Astralis1409/vikramsat_rf_subsystem/hardware_rf.step

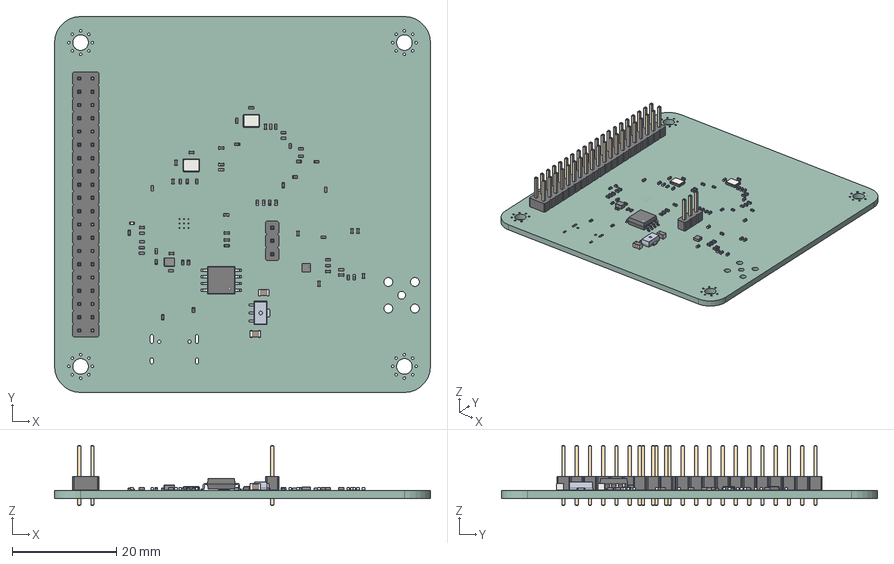
[picture p6: CAD file, 2025-08-02]
hardware_rf.step
72.0 x 72.0 x 11.5 mm
C_0402_1005Metric x 47
LED_0402_1005Metric
R_0402_1005Metric x 14
C_0805_2012Metric x 2
Crystal_SMD_3225-4Pin_3.2x2.5mm x 2
hardware_rf 1.44.1
PinHeader_2x20_P2.54mm_Vertical
IND-SMD_L2.0-W1.6_AOTA-B201610S3R3-101-T
DFN-6_L1.6-W1.6-P0.50-BL-EP1.0
PinHeader_1x03_P2.54mm_Vertical
SOIC-8_5.3x5.3mm_P1.27mm
hardware_rf_PCB
