Astralis1409/vikramsat_rf_subsystem/hardware_rf/footprints/4259-63/3D/4259-63.stp

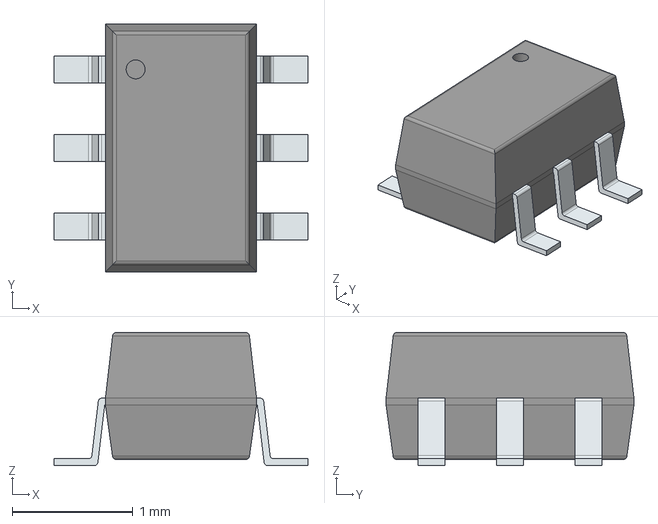
[picture p7: CAD file, 2025-07-22]
hardware_rf/footprints/4259-63/3D/4259-63.stp
2.10 x 2.05 x 1.10 mm
PinsArrayLR
