Astralis1409/vikramsat_rf_subsystem/hardware_rf/footprints/BALF-SPI2-02D3/3D/BALF-SPI2-02D3.stp

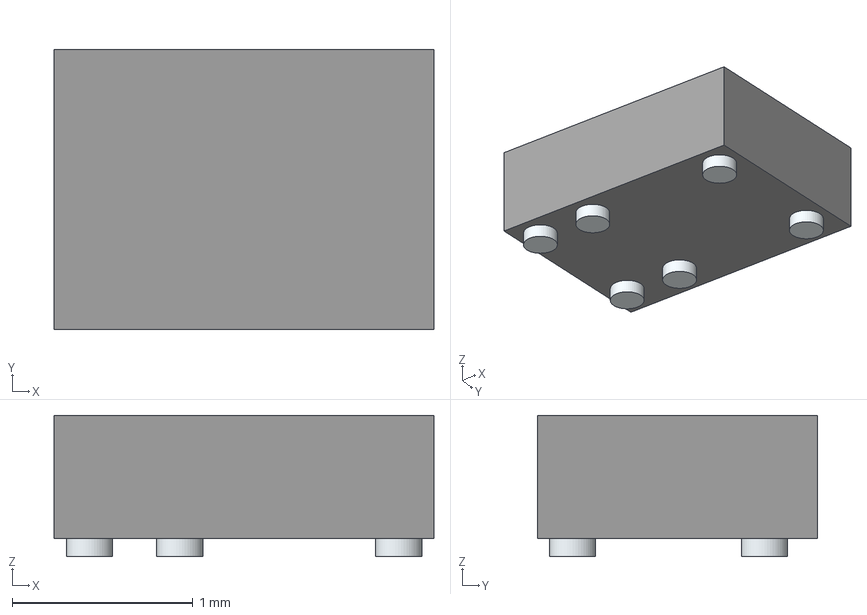
[picture p8: CAD file, 2025-07-22]
hardware_rf/footprints/BALF-SPI2-02D3/3D/BALF-SPI2-02D3.stp
2.10 x 1.55 x 0.78 mm
Pins
