Astralis1409/vikramsat_rf_subsystem/hardware_rf/footprints/CC1125RHBR/3D/CC1125RHBR.stp

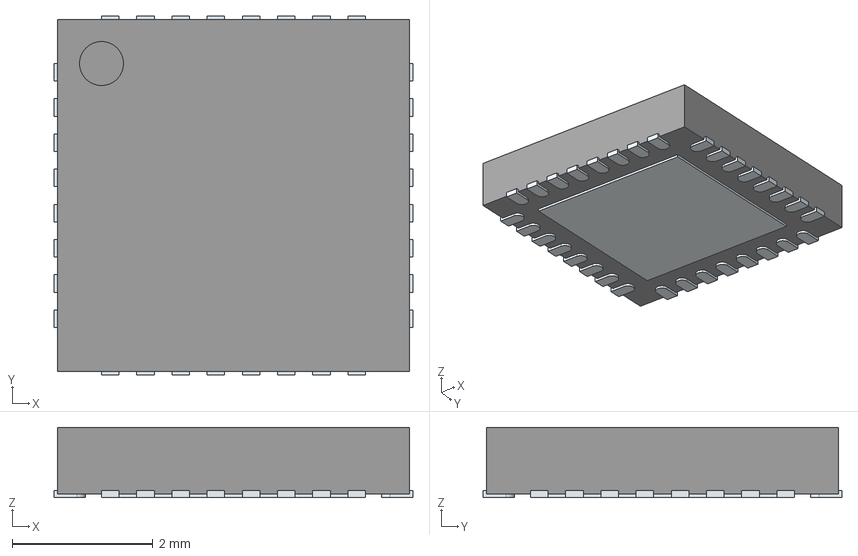
[picture p9: CAD file, 2025-07-10]
hardware_rf/footprints/CC1125RHBR/3D/CC1125RHBR.stp
5.10 x 5.10 x 1.00 mm
ThermalPin
PinsArrayLR
PinsArrayTB
