Astralis1409/vikramsat_rf_subsystem/(list of files, cad)

Other CAD files:
hardware_rf/footprints/4259-63/Allegro/sot65p210x110-6n.psm
hardware_rf/footprints/4259-63/DEHDL/4259_63/chips/chips.prt
hardware_rf/footprints/BALF-SPI2-02D3/Allegro/balfspi202d3.psm
hardware_rf/footprints/BALF-SPI2-02D3/DEHDL/balf_spi2_02d3/chips/chips.prt
hardware_rf/footprints/CC1125RHBR/Allegro/qfn50p500x500x100-33n-d.psm
hardware_rf/footprints/CC1125RHBR/DEHDL/cc1125rhbr/chips/chips.prt
