Astralis1409/vikramsat_rf_subsystem/hardware_rf.pdf

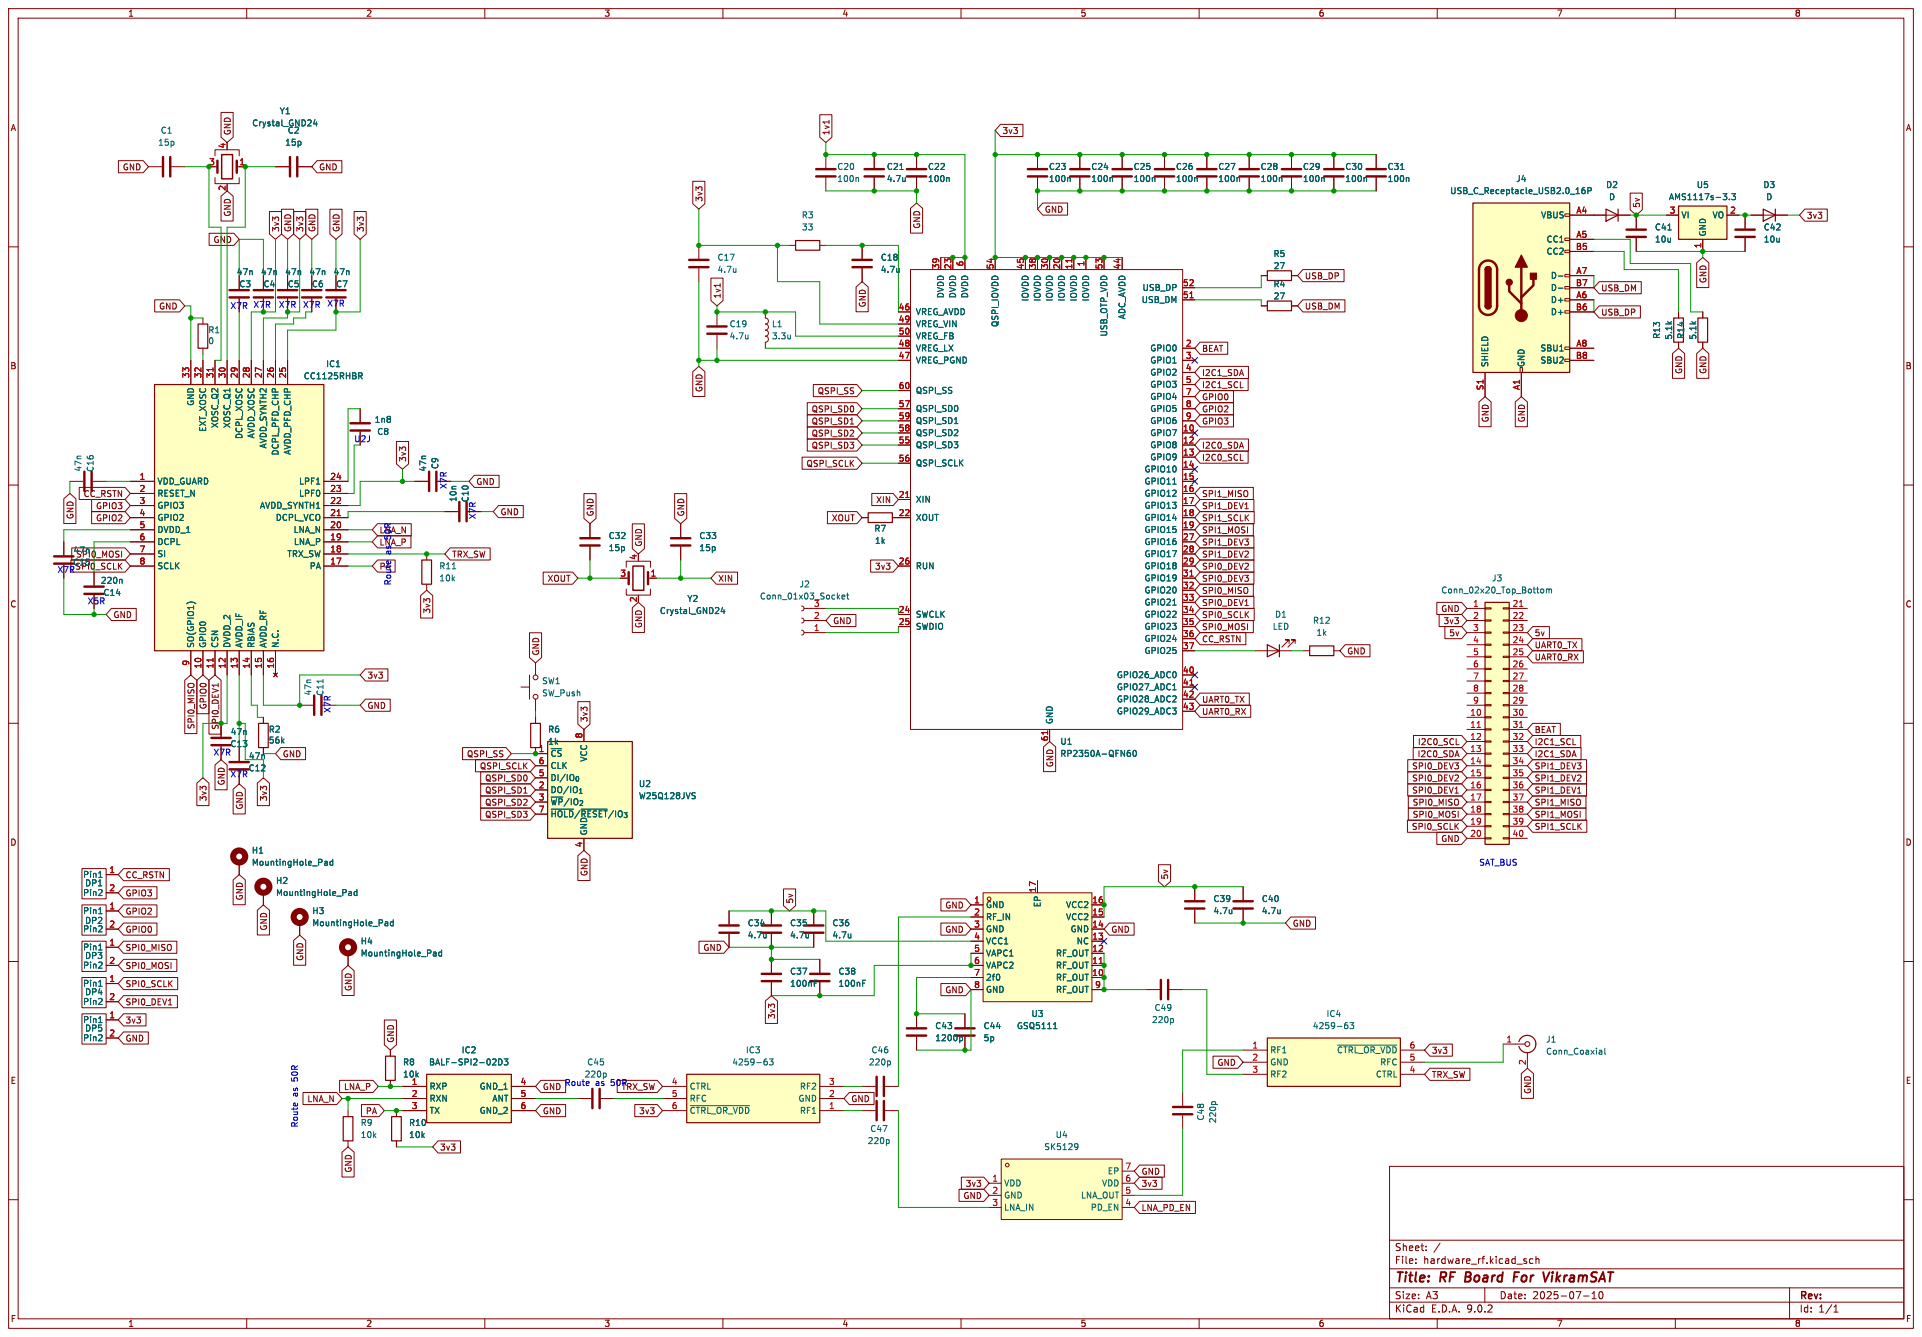
[picture p23: page 1]

6 QSPI_IOVDD 54 IOVDD 45 IOVDD 38 IOVDD 30 IOVDD 20 IOVDD 11 IOVDD

Id: 1/1 Title: RF Board For VikramSAT
