Astralis1409/vikramsat_rf_subsystem/(list of files, drawings)

Other design files:
hardware_rf/footprints/4259-63/Altium/4259-63.SchLib
hardware_rf/footprints/4259-63/Altium/SOT65P210X110-6N.PcbLib
hardware_rf/footprints/BALF-SPI2-02D3/Altium/BALF-SPI2-02D3.SchLib
hardware_rf/footprints/BALF-SPI2-02D3/Altium/BALFSPI202D3.PcbLib
hardware_rf/footprints/CC1125RHBR/Altium/CC1125RHBR.SchLib
hardware_rf/footprints/CC1125RHBR/Altium/QFN50P500X500X100-33N-D.PcbLib
