Astralis1409/vikramsat_rf_subsystem/hardware_rf/hardware_rf.kicad_pcb

## KiCad design hardware_rf/hardware_rf.kicad_pcb (2025-08-16)

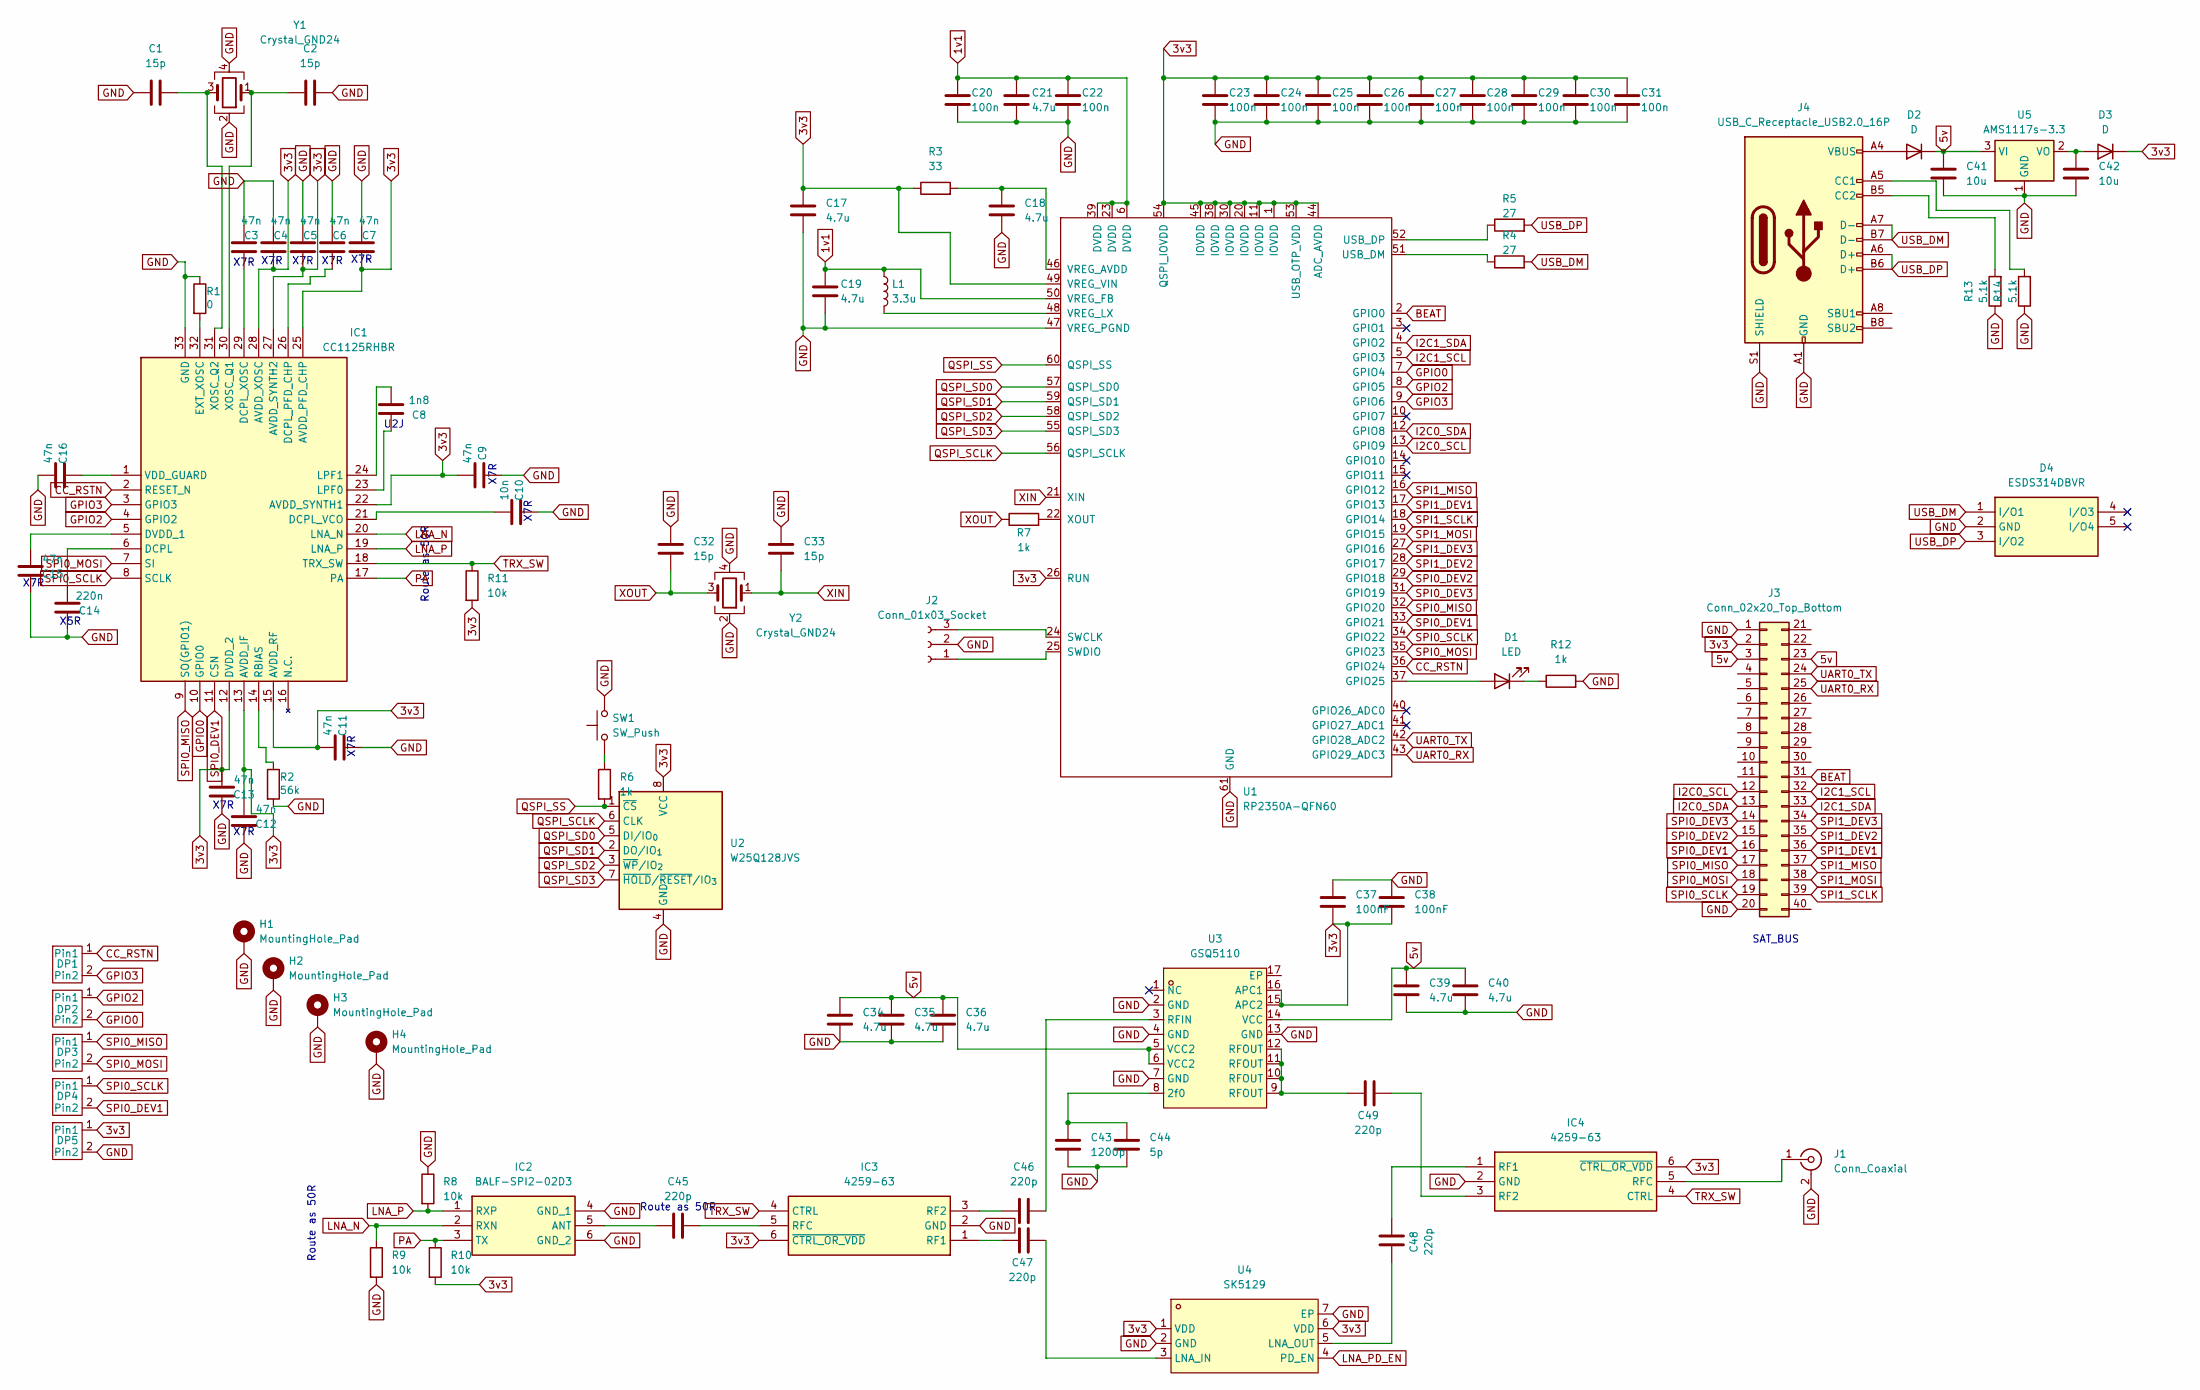
[picture p24: schematic hardware_rf.kicad_sch, RF Board For VikramSAT]

Parts:
C1, C2, C32, C33: 15p; C_0402_1005Metric
C3, C4, C5, C6, C7, C9, C11, C12, C13, C15, C16: 47n; C_0402_1005Metric
C8: 1n8; C_0402_1005Metric
C10: 10n; C_0402_1005Metric
C14: 220n; C_0402_1005Metric
C17, C18, C19, C21, C34, C35, C36, C39, C40: 4.7u; C_0402_1005Metric
C20, C22, C23, C24, C25, C26, C27, C28, C29, C30, C31: 100n; C_0402_1005Metric
C37, C38: 100nF; C_0402_1005Metric
C41, C42: 10u; C_0805_2012Metric
C43: 1200p; C_0402_1005Metric
C44: 5p; C_0402_1005Metric
C45, C46, C47, C48, C49: 220p; C_0402_1005Metric
D1: LED; LED_0402_1005Metric
D2, D3: D; D_0402_1005Metric
D4: ESDS314DBVR; ESDS314BVR_SOT95P280X145-5N; Mouser Part Number 595-ESDS314DBVR
DP1, DP2, DP3, DP4, DP5: Debug Pad
H1, H2, H3, H4: MountingHole_Pad; MountingHole_3mm_Pad_Via
IC1: CC1125RHBR; QFN50P500X500X100-33N-D; Mouser Part Number 595-CC1125RHBR
IC2: BALF-SPI2-02D3; BALFSPI202D3; Mouser Part Number 511-BALF-SPI2-02D3
IC3, IC4: 4259-63; PE4259; Mouser Part Number 81-4259-63
J1: Conn_Coaxial; SMA_Amphenol_901-143_Horizontal
J2: Conn_01x03_Socket; PinHeader_1x03_P2.54mm_Vertical
J3: Conn_02x20_Top_Bottom; PinHeader_2x20_P2.54mm_Vertical
J4: USB_C_Receptacle_USB2.0_16P; USB_C_Receptacle_XKB_U262-16XN-4BVC11
L1: 3.3u; IND-SMD_L2.0-W1.6_AOTA-B201610S3R3-101-T
R1: 0; R_0402_1005Metric
R2: 56k; R_0402_1005Metric
R3: 33; R_0402_1005Metric
R4, R5: 27; R_0402_1005Metric
R6, R7, R12: 1k; R_0402_1005Metric
R8, R9, R10, R11: 10k; R_0402_1005Metric
R13, R14: 5.1k; R_0402_1005Metric
SW1: SW_Push; SW_SPST_PTS810
U1: RP2350A-QFN60; RP2350A_QFN-60_EP_7.75x7.75_Pitch0.4mm
U2: W25Q128JVS; SOIC-8_5.3x5.3mm_P1.27mm
U3: GSQ5110; QFN-16_L3.0-W3.0-P0.50-TL-EP2.0; LCSC Part C41410390
U4: SK5129; DFN-6_L1.6-W1.6-P0.50-BL-EP1.0; LCSC Part C5120312
U5: AMS1117s-3.3; SOT-89-3
Y1, Y2: Crystal_GND24; Crystal_SMD_3225-4Pin_3.2x2.5mm

Connections:
1v1: C19.1, C20.1, C21.1, C22.1, L1.1, U1.6 (DVDD), U1.23 (DVDD), U1.39 (DVDD), U1.50 (VREG_FB)
3v3: C4.2, C5.2, C7.2, C9.1, C11.1, C12.1, C13.1, C17.1, C23.1, C24.1, C25.1, C26.1, C27.1, C28.1, C29.1, C30.1, C31.1, C37.2, C38.2, D3.1 (K), DP5.1 (Pin1), IC1.12 (DVDD_2), IC1.13 (AVDD_IF), IC1.15 (AVDD_RF), IC1.22 (AVDD_SYNTH1), IC1.25 (AVDD_PFD_CHP), IC1.27 (AVDD_SYNTH2), IC1.28 (AVDD_XOSC), IC3.6 (~CTRL_OR_VDD), IC4.6 (~CTRL_OR_VDD), J3.2, R3.1, R10.2, R11.2, U1.1 (IOVDD), U1.11 (IOVDD), U1.20 (IOVDD), U1.26 (RUN), U1.30 (IOVDD), U1.38 (IOVDD), U1.44 (ADC_AVDD), U1.45 (IOVDD), U1.49 (VREG_VIN), U1.53 (USB_OTP_VDD), U1.54 (QSPI_IOVDD), U2.8 (VCC), U3.15 (APC2), U3.16 (APC1), U4.1 (VDD), U4.6 (VDD)
5v: C34.1, C35.1, C36.1, C39.1, C40.1, C41.1, D2.1 (K), J3.3, J3.23, U3.5 (VCC2), U3.6 (VCC2), U3.14 (VCC), U5.3 (VI)
BEAT: J3.31, U1.2 (GPIO0)
CC_RSTN: DP1.1 (Pin1), IC1.2 (RESET_N), U1.36 (GPIO24)
GND: C1.2, C2.1, C3.1, C4.1, C5.1, C6.1, C7.1, C9.2, C10.2, C11.2, C12.2, C13.2, C14.2, C15.2, C16.1, C17.2, C18.2, C19.2, C20.2, C21.2, C22.2, C23.2, C24.2, C25.2, C26.2, C27.2, C28.2, C29.2, C30.2, C31.2, C32.1, C33.1, C34.2, C35.2, C36.2, C37.1, C38.1, C39.2, C40.2, C41.2, C42.2, C43.2, C44.2, D4.2 (GND), DP5.2 (Pin2), H1.1, H2.1, H3.1, H4.1, IC1.33 (GND), IC2.4 (GND_1), IC2.6 (GND_2), IC3.2 (GND), IC4.2 (GND), J1.2 (Ext), J2.2, J3.1, J3.20, J4.A1 (GND), J4.A12 (GND), J4.B1 (GND), J4.B12 (GND), J4.S1 (SHIELD), R1.1, R2.2, R8.1, R9.2, R12.2, R13.1, R14.1, SW1.2, U1.47 (VREG_PGND), U1.61 (GND), U2.4 (GND), U3.2 (GND), U3.4 (GND), U3.7 (GND), U3.13 (GND), U4.2 (GND), U4.7 (EP), U5.1 (GND), Y1.2, Y1.4, Y2.2, Y2.4
GPIO0: DP2.2 (Pin2), IC1.10 (GPIO0), U1.7 (GPIO4)
GPIO2: DP2.1 (Pin1), IC1.4 (GPIO2), U1.8 (GPIO5)
GPIO3: DP1.2 (Pin2), IC1.3 (GPIO3), U1.9 (GPIO6)
I2C0_SCL: J3.12, U1.13 (GPIO9)
I2C0_SDA: J3.13, U1.12 (GPIO8)
I2C1_SCL: J3.32, U1.5 (GPIO3)
I2C1_SDA: J3.33, U1.4 (GPIO2)
LNA_N: IC1.20 (LNA_N), IC2.2 (RXN), R9.1
LNA_P: IC1.19 (LNA_P), IC2.1 (RXP), R8.2
LNA_PD_EN: U4.4 (PD_EN)
unnamed: C49.1, U3.9 (RFOUT), U3.10 (RFOUT), U3.11 (RFOUT), U3.12 (RFOUT)
unnamed: D1.2 (A), U1.37 (GPIO25)
unnamed: D1.1 (K), R12.1
unnamed: D2.2 (A), J4.A4 (VBUS), J4.A9 (VBUS), J4.B4 (VBUS), J4.B9 (VBUS)
unnamed: C42.1, D3.2 (A), U5.2 (VO)
unnamed: C14.1, IC1.6 (DCPL)
unnamed: C6.2, IC1.26 (DCPL_PFD_CHP)
unnamed: C10.1, IC1.21 (DCPL_VCO)
unnamed: C3.2, IC1.29 (DCPL_XOSC)
unnamed: C15.1, IC1.5 (DVDD_1)
unnamed: IC1.32 (EXT_XOSC), R1.2
unnamed: C8.2, IC1.23 (LPF0)
unnamed: C8.1, IC1.24 (LPF1)
unnamed: IC1.14 (RBIAS), R2.1
unnamed: C16.2, IC1.1 (VDD_GUARD)
unnamed: C2.2, IC1.30 (XOSC_Q1), Y1.1
unnamed: C1.1, IC1.31 (XOSC_Q2), Y1.3
unnamed: C45.1, IC2.5 (ANT)
unnamed: C47.1, IC3.1 (RF1)
unnamed: C46.1, IC3.3 (RF2)
unnamed: C45.2, IC3.5 (RFC)
unnamed: C48.2, IC4.1 (RF1)
unnamed: C49.2, IC4.3 (RF2)
unnamed: IC4.5 (RFC), J1.1 (In)
unnamed: J2.1, U1.25 (SWDIO)
unnamed: J2.3, U1.24 (SWCLK)
unnamed: J4.A5 (CC1), R14.2
unnamed: J4.B5 (CC2), R13.2
unnamed: R6.1, SW1.1
unnamed: R4.1, U1.51 (USB_DM)
unnamed: R5.1, U1.52 (USB_DP)
unnamed: C18.1, R3.2, U1.46 (VREG_AVDD)
unnamed: L1.2, U1.48 (VREG_LX)
unnamed: R7.2, U1.22 (XOUT)
unnamed: C43.1, C44.1, U3.8 (2f0)
unnamed: C46.2, U3.3 (RFIN)
unnamed: C47.2, U4.3 (LNA_IN)
unnamed: C48.1, U4.5 (LNA_OUT)
PA: IC1.17 (PA), IC2.3 (TX), R10.1
QSPI_SCLK: U1.56 (QSPI_SCLK), U2.6 (CLK)
QSPI_SD0: U1.57 (QSPI_SD0), U2.5 (DI/IO_{0})
QSPI_SD1: U1.59 (QSPI_SD1), U2.2 (DO/IO_{1})
QSPI_SD2: U1.58 (QSPI_SD2), U2.3 (~WP/IO_{2})
QSPI_SD3: U1.55 (QSPI_SD3), U2.7 (~HOLD/~RESET/IO_{3})
QSPI_SS: R6.2, U1.60 (QSPI_SS), U2.1 (~CS)
SPI0_DEV1: DP4.2 (Pin2), IC1.11 (CSN), J3.16, U1.33 (GPIO21)
SPI0_DEV2: J3.15, U1.29 (GPIO18)
SPI0_DEV3: J3.14, U1.31 (GPIO19)
SPI0_MISO: DP3.1 (Pin1), IC1.9 (SO(GPIO1)), J3.17, U1.32 (GPIO20)
SPI0_MOSI: DP3.2 (Pin2), IC1.7 (SI), J3.18, U1.35 (GPIO23)
SPI0_SCLK: DP4.1 (Pin1), IC1.8 (SCLK), J3.19, U1.34 (GPIO22)
SPI1_DEV1: J3.36, U1.17 (GPIO13)
SPI1_DEV2: J3.35, U1.28 (GPIO17)
SPI1_DEV3: J3.34, U1.27 (GPIO16)
SPI1_MISO: J3.37, U1.16 (GPIO12)
SPI1_MOSI: J3.38, U1.19 (GPIO15)
SPI1_SCLK: J3.39, U1.18 (GPIO14)
TRX_SW: IC1.18 (TRX_SW), IC3.4 (CTRL), IC4.4 (CTRL), R11.1
UART0_RX: J3.25, U1.43 (GPIO29_ADC3)
UART0_TX: J3.24, U1.42 (GPIO28_ADC2)
USB_DM: D4.1 (I/O1), J4.A7 (D-), J4.B7 (D-), R4.2
USB_DP: D4.3 (I/O2), J4.A6 (D+), J4.B6 (D+), R5.2
XIN: C33.2, U1.21 (XIN), Y2.1
XOUT: C32.2, R7.1, Y2.3

Notes on the sheet:
Route as 50R
X7R
X5R
SAT_BUS
U2J

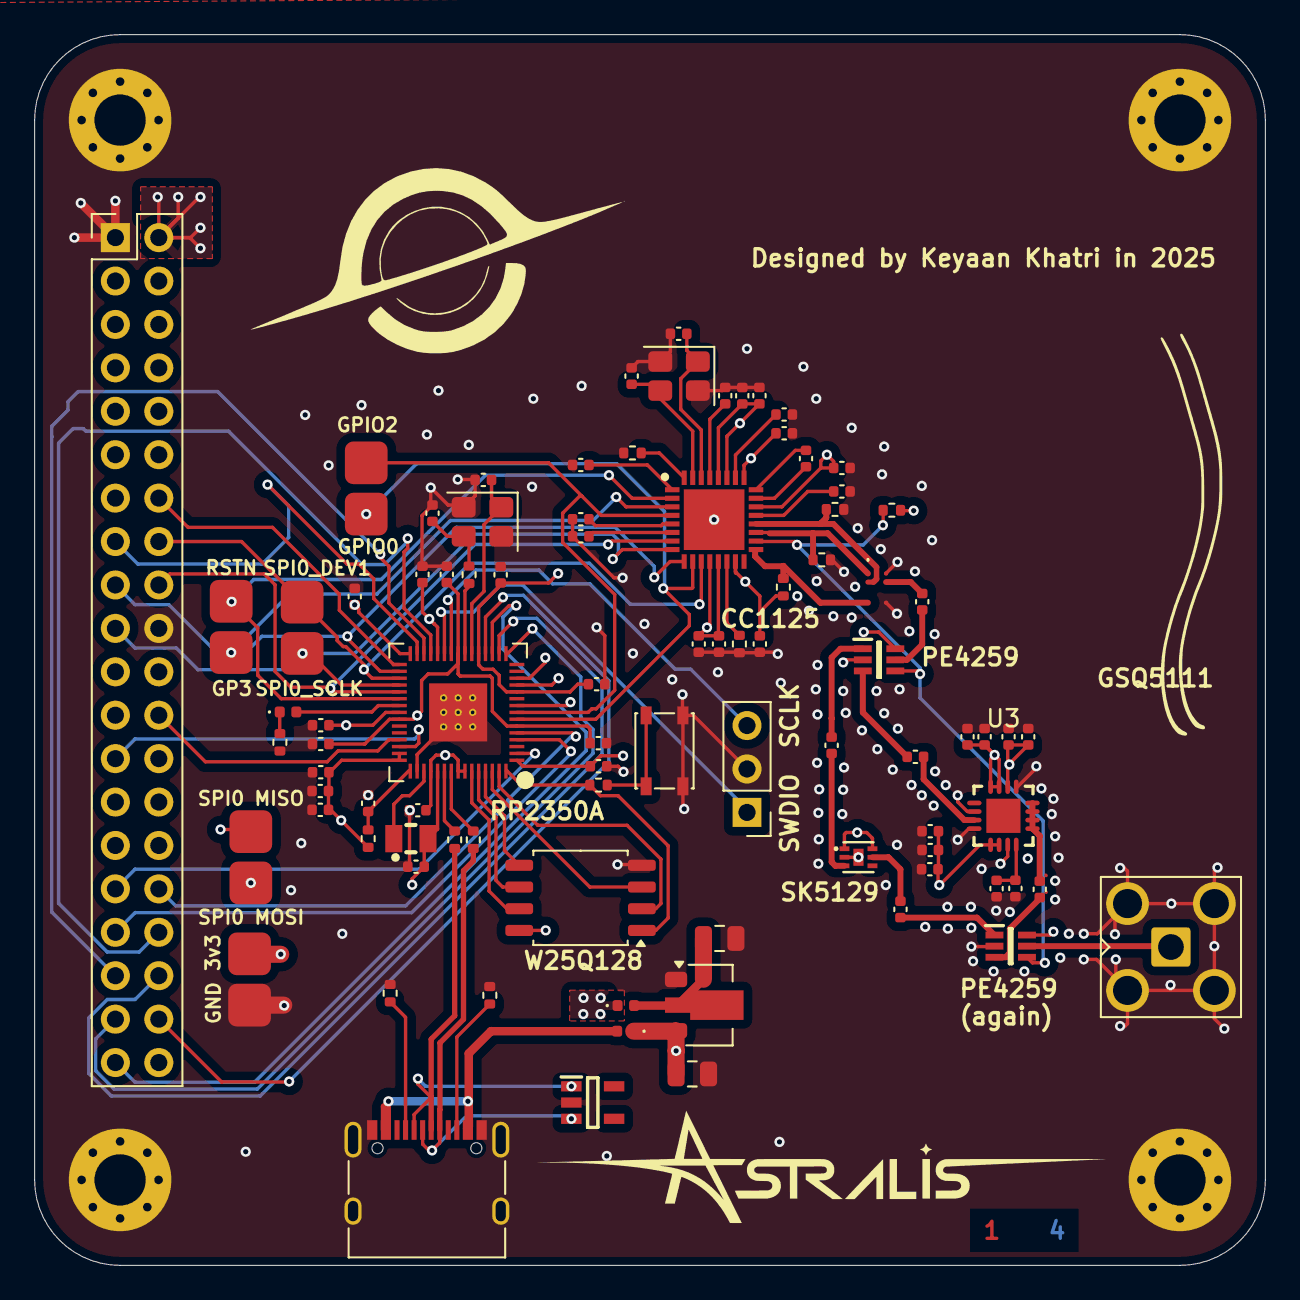
[picture p25: board hardware_rf.kicad_pcb from above]

Board: 4 copper layers, 72.0 x 72.0 mm, 93 parts (0 on the bottom side), 79 nets.
