Astralis1409/vikramsat_rf_subsystem/(commit log)

2025-07-10 schematic work
    [hardware_rf.kicad_sch]
2025-07-21 new footprint
2025-07-30 Schematic Done
    [hardware_rf.kicad_sch]
2025-07-30 Assignment of footprints
    [hardware_rf.kicad_sch]
2025-07-31 pcb components added
    [bom.csv, pcb.csv]
2025-07-31 Pcb Done
    [bom.csv, designators.csv, hardware_rf.kicad_pcb, hardware_rf.kicad_sch, positions.csv]
2025-07-31 add bom
    [bom.csv]
2025-08-01 CC lines on USB fixed
    [hardware_rf.kicad_pcb, hardware_rf.kicad_sch, pcb.csv]
2025-08-01 update bom
    [bom.csv]
2025-08-01 step addition
    [hardware_rf.step]
2025-08-02 Added SWD Header
    [bom.csv]
2025-08-02 Added SWD to PCB
    [bom.csv, designators.csv, hardware_rf.kicad_pcb, hardware_rf.kicad_sch, positions.csv]
2025-08-02 3d Model add
    [hardware_rf.step]
2025-08-03 Update USB Connector pos
2025-08-03 Update USB C Position
    [hardware_rf.kicad_pcb, positions.csv]
2025-08-16 added ESD Protection and Moved USB-C Connector pos
    [bom.csv, designators.csv, hardware_rf.kicad_pcb, hardware_rf.kicad_sch, positions.csv]
2025-08-16 Update PA
    [bom.csv, hardware_rf.kicad_pcb, hardware_rf.kicad_sch, positions.csv]
